versioduo/radio/hardware/button-laser.dxf

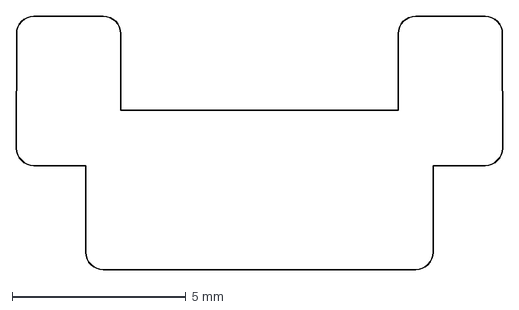
[picture p1: CAD file, 2025-12-29]
hardware/button-laser.dxf
14.0 x 7.30 mm
