versioduo/radio/hardware/radio.pdf

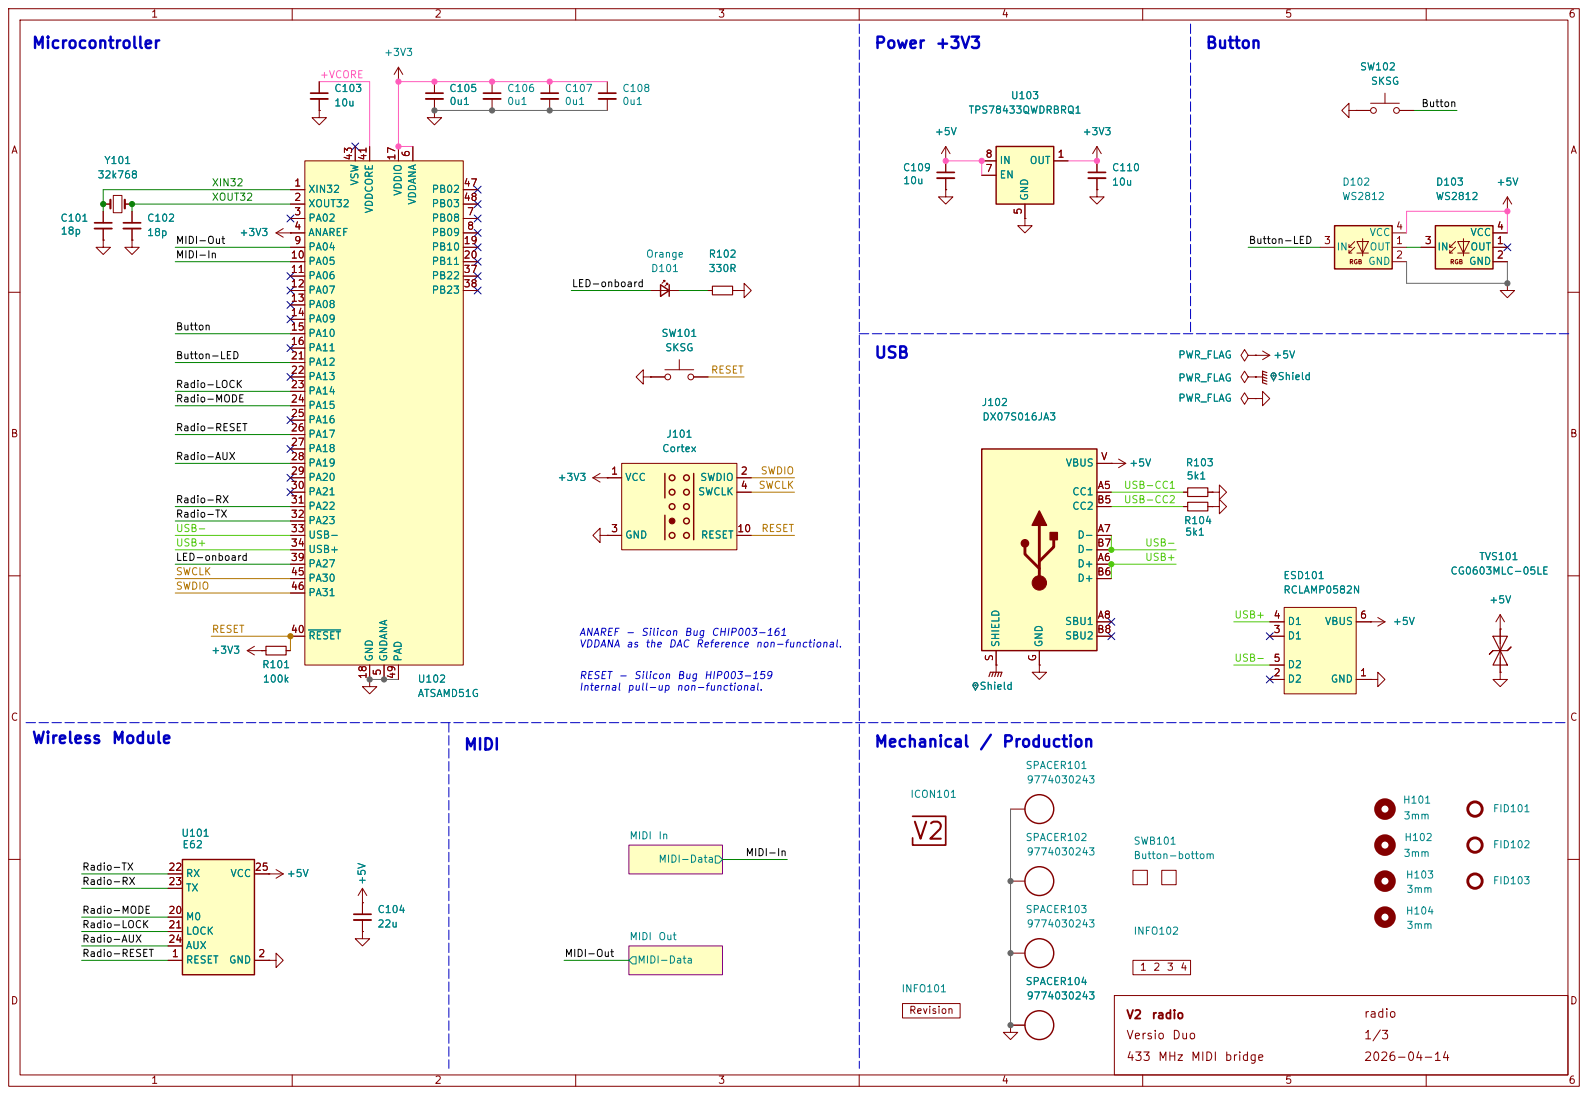
[picture p2: page 1]

Radio-TX Radio-RX

Radio-AUX Radio-RESET

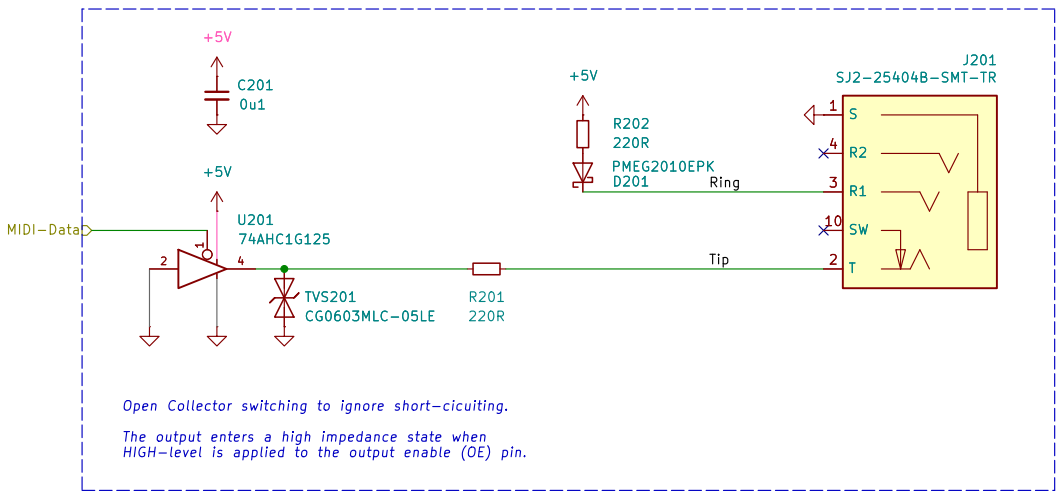
[picture p3: page 2]

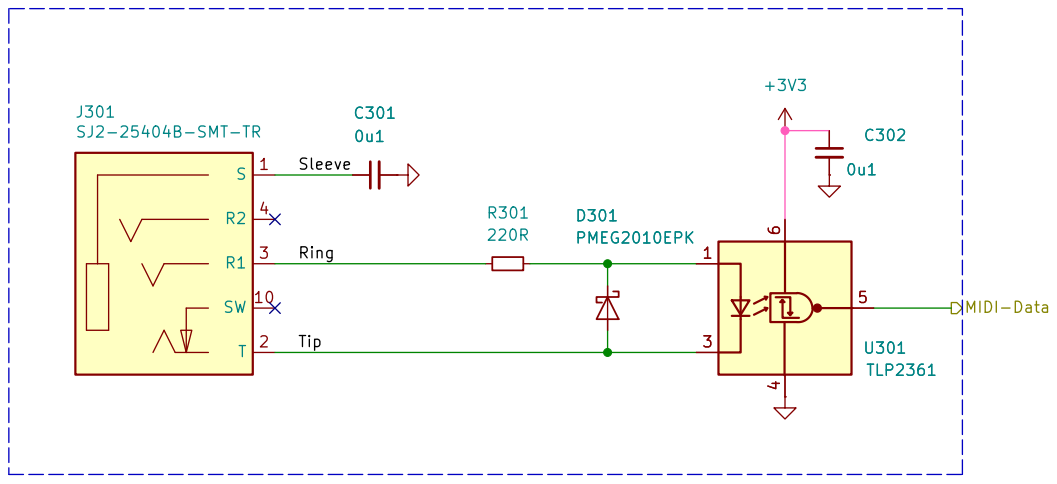
[picture p4: page 3]
