versioduo/radio/hardware/radio.kicad_pcb

## KiCad design hardware/radio.kicad_pcb (2026-04-14)

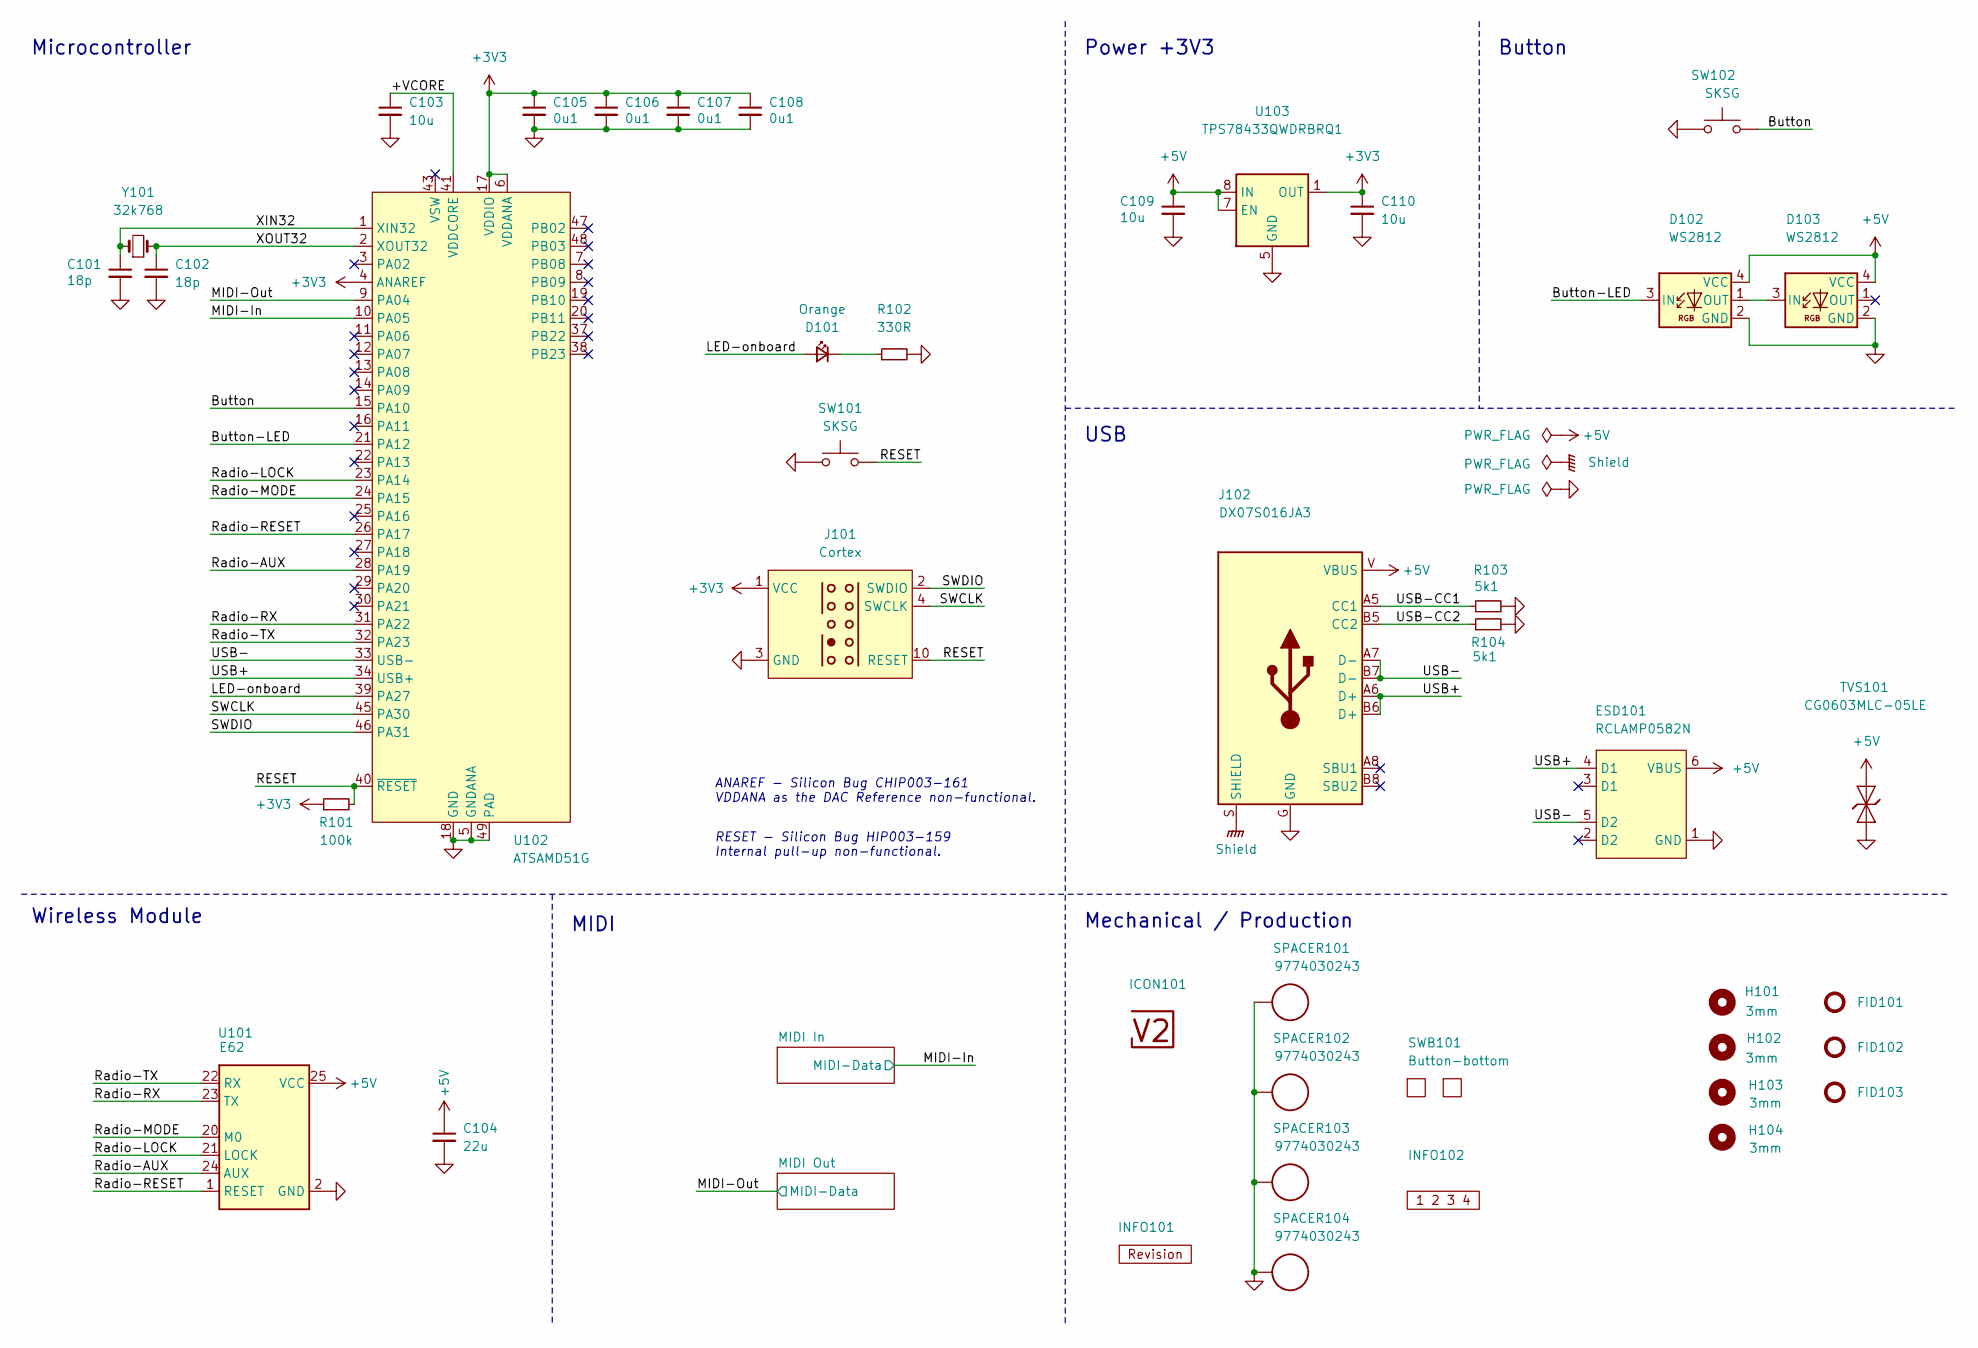
[picture p5: schematic radio.kicad_sch, V2 radio]

Parts:
C101, C102: 18p; C_0603; Rating 50V; Mouser 810-CGA3E2C0G1H180J
C103: 10u; C_0603; Rating 10V; Mouser 810-C1608X6S1A106M
C104: 22u; C_1210; Rating 25V; Mouser 810-CGA6P3X7R1E226M5
C105, C106, C107, C108: 0u1; C_0603; Rating 50V; Mouser 810-CGA3E2X7R1H104MA
C109, C110: 10u; C_0805; Rating 25V; Mouser 810-C2012X5R1E106K
D101: Orange; LED_0603; Rating 605nm; Mouser 755-SML-D12D1WT86
D102, D103: WS2812; WS2812-2020; Rating 15mA; LCSC C965555
ESD101: RCLAMP0582N; SLP1210N6; Rating 20kV; Mouser 947-RCLAMP0582N.TCT
FID101, FID102, FID103: Fiducial_Paste; Fiducial_0.5mm_Mask1mm_Paste
H101, H102, H103, H104: 3mm; MountingHole_3mm
ICON101: V2-logo; Logo_Small
INFO101: Revision
INFO102: Layer_Numbers
J101: Cortex
J102: DX07S016JA3; JAE_DX07S016JA3; Rating USB2.0; Mouser 656-DX07S016JA3R1500
R101: 100k; R_0603; Rating 100mW; Mouser 71-CRCW0603100KFKEAC
R102: 330R; R_0603; Rating 100mW; Mouser 71-CRCW0603330RFKEAC
R103, R104: 5k1; R_0603; Rating 100mW; Mouser 71-CRCW06035K10FKEAC
SPACER101, SPACER102, SPACER103, SPACER104: 9774030243; Rating 3mm; Mouser 710-9774030243R
SW101, SW102: SKSG; Rating 1.6N; Mouser 688-SKSGACE010
SWB101: Button-bottom; PCB_Button-bottom
TVS101: CG0603MLC-05LE; D_0603; Rating 5V; Mouser 652-CG0603MLC-05LE
U101: E62; Rating 433Mhz
U102: ATSAMD51G; QFN-48-1EP_7x7mm_P0.5mm_EP5.45x5.45mm_ThermalVias; Rating Cortex-M4F; Mouser 556-ATSAMD51G19AMU
U103: TPS78433QWDRBRQ1; VSON-8-1_3x3mm_P0.65_EP1.65x2.4mm; Rating 300mA; Mouser 595-TPS78433QWDRBRQ1
Y101: 32k768; Crystal_SMD_3215-2Pin_3.2x1.5mm; Rating 10ppm; Mouser 815-ABS0716632.768KT

Connections:
+3V3: C105.1, C106.1, C107.1, C108.1, C110.1, J101.1 (VCC), R101.1, U102.4 (ANAREF), U102.6 (VDDANA), U102.17 (VDDIO), U102.36 (VDDIO), U102.44 (VDDIO), U103.1 (OUT); also elsewhere on the board
+5V: C104.1, C109.1, D102.4 (VCC), D103.4 (VCC), ESD101.6 (VBUS), J102.V (VBUS), TVS101.2 (A), U101.25 (VCC), U103.7 (EN), U103.8 (IN); also elsewhere on the board
/+VCORE: C103.1, U102.41 (VDDCORE)
/Button: SW102.2, U102.15 (PA10)
/Button-LED: D102.3 (IN), U102.21 (PA12)
/LED-onboard: D101.2 (A), U102.39 (PA27)
/MIDI-In: U102.10 (PA05); also elsewhere on the board
/MIDI-Out: U102.9 (PA04); also elsewhere on the board
/RESET: J101.10 (RESET), R101.2, SW101.2, U102.40 (~RESET)
/Radio-AUX: U101.24 (AUX), U102.28 (PA19)
/Radio-LOCK: U101.21 (LOCK), U102.23 (PA14)
/Radio-MODE: U101.20 (M0), U102.24 (PA15)
/Radio-RESET: U101.1 (RESET), U102.26 (PA17)
/Radio-RX: U101.23 (TX), U102.31 (PA22)
/Radio-TX: U101.22 (RX), U102.32 (PA23)
/SWCLK: J101.4 (SWCLK), U102.45 (PA30)
/SWDIO: J101.2 (SWDIO), U102.46 (PA31)
/Shield: J102.S (SHIELD)
/USB+: ESD101.4 (D1), J102.A6 (D+), J102.B6 (D+), U102.34 (USB+)
/USB-: ESD101.5 (D2), J102.A7 (D-), J102.B7 (D-), U102.33 (USB-)
/USB-CC1: J102.A5 (CC1), R103.1
/USB-CC2: J102.B5 (CC2), R104.1
/XIN32: C101.1, U102.1 (XIN32), Y101.1
/XOUT32: C102.1, U102.2 (XOUT32), Y101.2
GND: C101.2, C102.2, C103.2, C104.2, C105.2, C106.2, C107.2, C108.2, C109.2, C110.2, D102.2 (GND), D103.2 (GND), ESD101.1 (GND), J101.3 (GND), J101.5 (GND), J102.G (GND), R102.2, R103.2, R104.2, SPACER101.1 (1_1), SPACER102.1 (1_1), SPACER103.1 (1_1), SPACER104.1 (1_1), SW101.1, SW102.1, TVS101.1 (K), U101.2 (GND), U101.8 (GND), U101.11 (GND), U101.13 (GND), U101.14 (GND), U101.15 (GND), U101.16 (GND), U101.19 (GND), U101.26 (GND), U102.5 (GNDANA), U102.18 (GND), U102.35 (GND), U102.42 (GND), U102.49 (PAD), U103.5 (GND), U103.9 (GND); also elsewhere on the board
unnamed: D101.1 (K), R102.1
unnamed: D102.1 (OUT), D103.3 (IN)

Notes on the sheet:
ANAREF -  Silicon Bug CHIP003-161 VDDANA as the DAC Reference non-functional.
Wireless Module
RESET -  Silicon Bug HIP003-159 Internal pull-up non-functional.
Button
Power +3V3
Mechanical / Production
Microcontroller
USB
MIDI

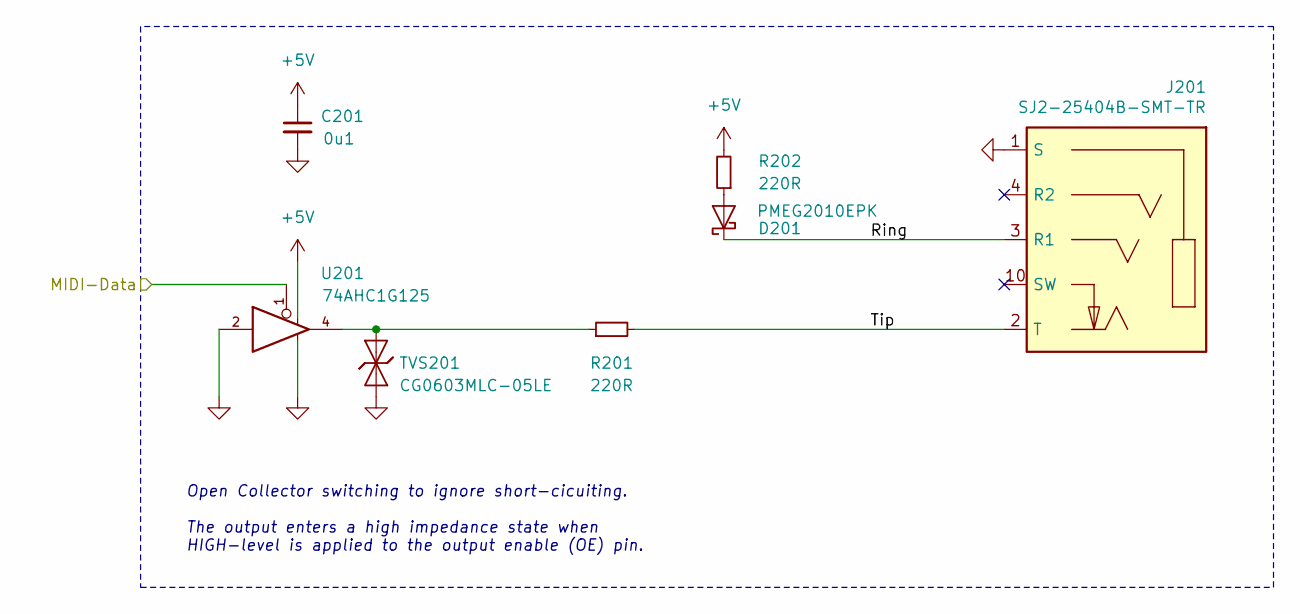
[picture p6: schematic MIDIOut.kicad_sch, V2 radio]

Parts:
C201: 0u1; C_0603; Rating 50V; Mouser 810-CGA3E2X7R1H104MA
D201: PMEG2010EPK; D_SOD-1608; Rating 20V; Mouser 771-PMEG2010EPK
J201: SJ2-25404B-SMT-TR; CUI_SJ2-25404B-SMT-TR; Rating 2.5mm; Mouser 490-SJ2-25404BSMT-TR
R201, R202: 220R; R_0603; Rating 330mW; Mouser 71-CRCW0603220RFKEAH
TVS201: CG0603MLC-05LE; D_0603; Rating 5V; Mouser 652-CG0603MLC-05LE
U201: 74AHC1G125; SOT-23-5; Rating 8mA; Mouser 595-SN74AHC1G125DBVR

Connections:
+5V: C201.1, R202.2, U201.5; also elsewhere on the board
/MIDI Out/Ring: D201.1 (K), J201.3 (R1)
/MIDI Out/Tip: J201.2 (T), R201.2
/MIDI-Out: U201.1; also elsewhere on the board
GND: C201.2, J201.1 (S), TVS201.1 (K), U201.2, U201.3; also elsewhere on the board
unnamed: D201.2 (A), R202.1
unnamed: R201.1, TVS201.2 (A), U201.4

Notes on the sheet:
 Open Collector switching to ignore short-cicuiting. The output enters a high impedance state when HIGH-level is applied to the output enable (OE) pin.

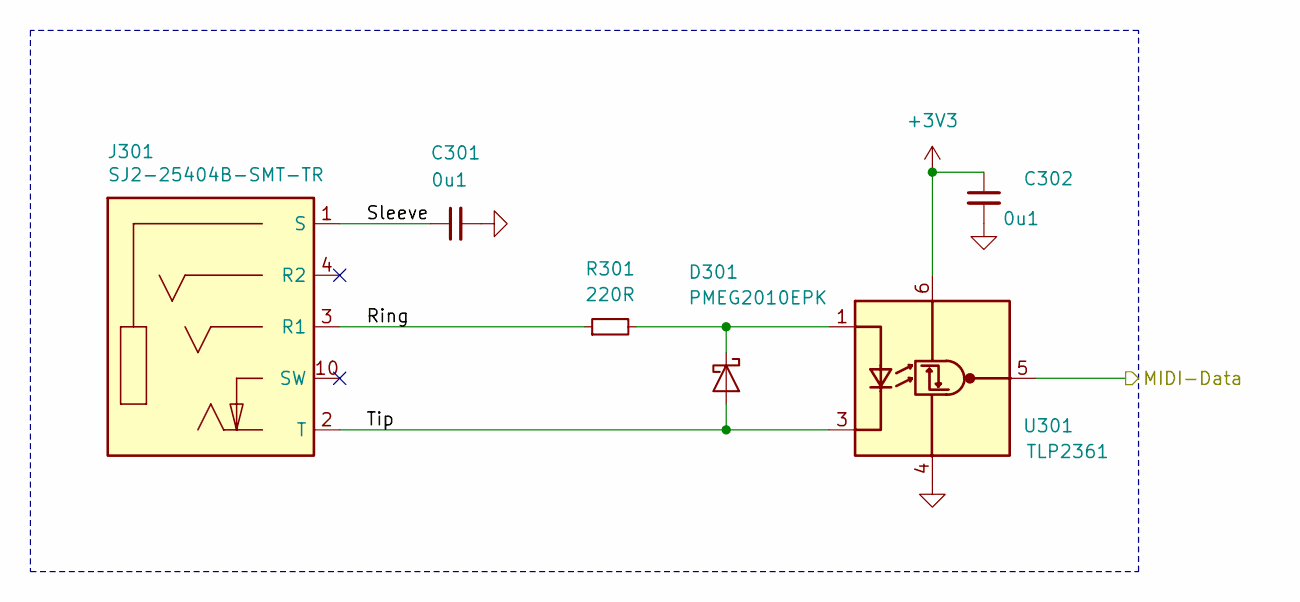
[picture p7: schematic MIDIIn.kicad_sch, V2 radio]

Parts:
C301, C302: 0u1; C_0603; Rating 50V; Mouser 810-CGA3E2X7R1H104MA
D301: PMEG2010EPK; D_SOD-1608; Rating 20V; Mouser 771-PMEG2010EPK
J301: SJ2-25404B-SMT-TR; CUI_SJ2-25404B-SMT-TR; Rating 2.5mm; Mouser 490-SJ2-25404BSMT-TR
R301: 220R; R_0603; Rating 330mW; Mouser 71-CRCW0603220RFKEAH
U301: TLP2361; SO-5-6_4.55x3.7mm_P1.27mm; Rating 15Mbps; Mouser 757-TLP2361TPRE

Connections:
+3V3: C302.1, U301.6 (VDD); also elsewhere on the board
/MIDI In/Ring: J301.3 (R1), R301.1
/MIDI In/Sleeve: C301.1, J301.1 (S)
/MIDI In/Tip: D301.2 (A), J301.2 (T), U301.3 (K)
/MIDI-In: U301.5 (VO); also elsewhere on the board
GND: C301.2, C302.2, U301.4 (GND); also elsewhere on the board
unnamed: D301.1 (K), R301.2, U301.1 (A)

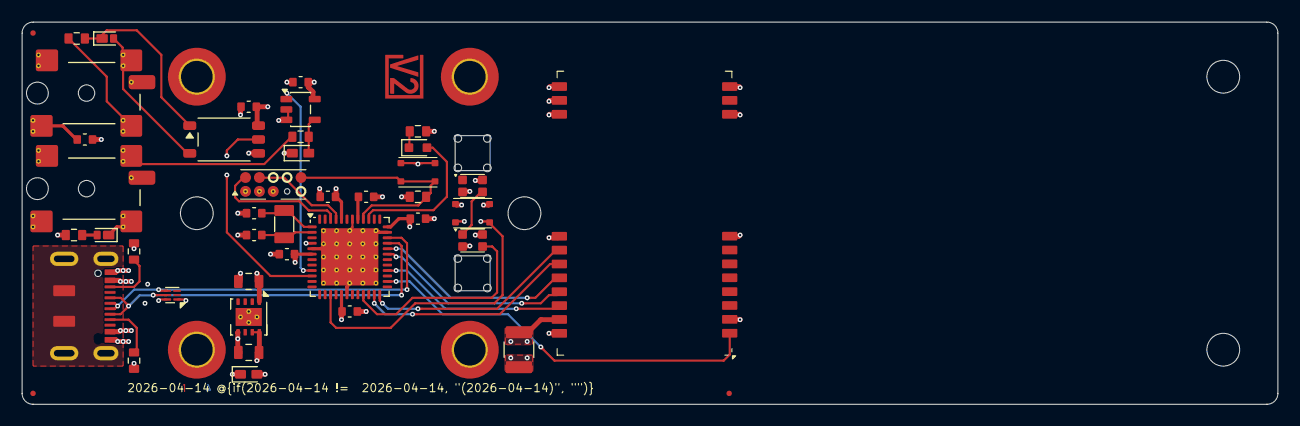
[picture p8: board radio.kicad_pcb from above]

Board: 4 copper layers, 115.0 x 35.0 mm, 55 parts (0 on the bottom side), 34 nets.
