versioduo/radio/(commit log)

2026-02-13 Replace Order_Number
    [MIDIIn.kicad_sch, MIDIOut.kicad_sch, PowerSupply.kicad_sch, cover.kicad_pcb, cover.kicad_sch, radio.kicad_pcb, radio.kicad_sch]
2026-02-15 Update Library
    [MIDIIn.kicad_sch, MIDIOut.kicad_sch, cover.kicad_pcb, cover.kicad_sch, radio.kicad_pcb, radio.kicad_sch]
2026-03-14 Update ESD suppressor
    [MIDIIn.kicad_sch, MIDIOut.kicad_sch, radio.kicad_pcb, radio.kicad_sch]
2026-03-30 Replace diode
    [MIDIIn.kicad_sch, MIDIOut.kicad_sch, radio.kicad_pcb, radio.kicad_sch]
2026-05-11 Good Bye Imperial
    [MIDIIn.kicad_sch, MIDIOut.kicad_sch, radio.kicad_sch]
